rps9/EC463_Team_03_HUD_Glasses/images/temp_d849b771-32f3-4060-8334-6a91f4f5c3f0.jpg

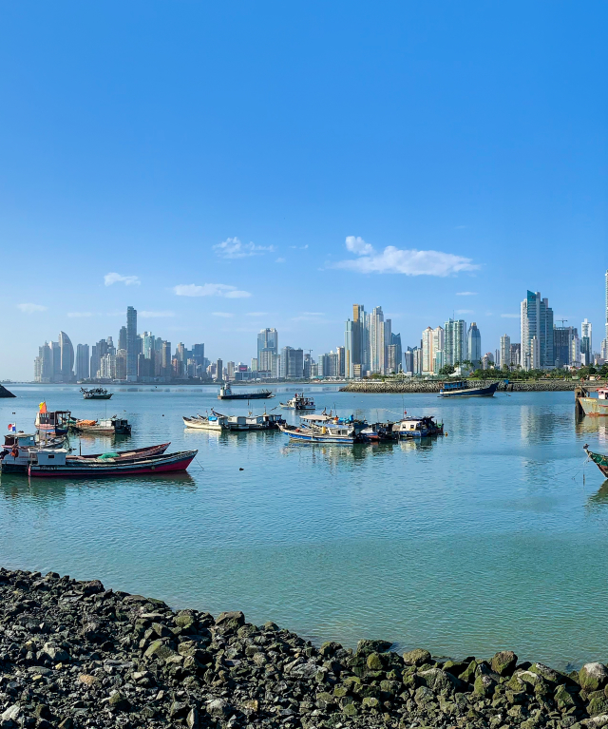
images/temp_d849b771-32f3-4060-8334-6a91f4f5c3f0.jpg
