rps9/EC463_Team_03_HUD_Glasses/README.md

# Team 3: HUDini

<p align="center">

</p>
<p align="center">
This is our team
</p>

## Description
We’re building a live translation device that utilizes a microphone and Head-Up Display (HUD) to turn spoken foreign speech into real-time English captions, all housed in a pair of glasses. A companion app learns user style to suggest relevant replies, which are displayed phonetically for easy pronunciation on the HUD.

## Objectives
The HUDini will enable fluid two-way conversation, accelerate language learning, and generally facilitate communication across various languages. Planned deliverables: working product with live speech translation and response suggestion.

## Team links
- [Team Google Drive](https://drive.google.com/drive/folders/1bL06aGVt6rRM7B_IEEJm4XVPyzq0NuTs)

## Course links
- [ECE Senior Design Piazza Site](https://piazza.com/bu/fall2025/ec463/home)
- [Blackboard](http://learn.bu.edu/)

## Optional features links
- [Team Jira](https://hudinihudini.atlassian.net/jira/software/projects/SCRUM/boards/1/backlog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)
