rps9/EC463_Team_03_HUD_Glasses/hardware/pcb/HUDini_charger/HUDini.csv

Reference | Qty | Value | DNP | Exclude from BOM | Exclude from Board | Footprint | Datasheet
BT1,BT2 | 2 | LIR2450 |  |  |  | Connector_Wire:SolderWire-0.15sqmm_1x02_P4mm_D0.5mm_OD1.5mm | ~
C1,C2,C6,C8,C9,C12,C16 | 7 | 0.1uF |  |  |  | Capacitor_SMD:C_0603_1608Metric_Pad1.08x0.95mm_HandSolder | ~
C3,C4,C5,C15 | 4 | 4.7uF |  |  |  | Capacitor_SMD:C_0603_1608Metric_Pad1.08x0.95mm_HandSolder | ~
C7,C11,C13,C14 | 4 | 10uF |  |  |  | Capacitor_SMD:C_0603_1608Metric_Pad1.08x0.95mm_HandSolder | ~
C10 | 1 | 1uF |  |  |  | Capacitor_SMD:C_0603_1608Metric_Pad1.08x0.95mm_HandSolder | ~
D1,D4 | 2 | LED |  |  |  | LED_SMD:LED_0603_1608Metric_Pad1.05x0.95mm_HandSolder | ~
D2 | 1 | SP0503BAHT |  |  |  | Package_TO_SOT_SMD:SOT-143 | http://www.littelfuse.com/~/media/files/littelfuse/technical%20resources/documents/data%20sheets/sp05xxba.pdf
J1 | 1 | USB_B_Micro |  |  |  | Connector_USB:USB_Micro-B_Amphenol_10103594-0001LF_Horizontal | ~
J3 | 1 | Conn_01x06_Pin |  |  |  | Connector_Wire:SolderWire-0.15sqmm_1x06_P4mm_D0.5mm_OD1.5mm | ~
J4 | 1 | Conn_01x07_Pin |  |  |  | Connector_PinHeader_2.00mm:PinHeader_1x07_P2.00mm_Horizontal | ~
L1 | 1 | LPS3015-153MRC |  |  |  | footprints:LPS3015 | LPS3015-153MRC
Q1,Q2 | 2 | Q_NMOS_SSSGD_AvalancheRated |  |  |  | Package_SON:VSON-8_3.3x3.3mm_P0.65mm_NexFET | ~
R1 | 1 | 5.1M |  | Excluded from BOM |  | Resistor_SMD:R_0603_1608Metric_Pad0.98x0.95mm_HandSolder | ~
R2 | 1 | 5.1M |  |  |  | Resistor_SMD:R_0603_1608Metric_Pad0.98x0.95mm_HandSolder | ~
R3 | 1 | 2.2K |  |  |  | Resistor_SMD:R_0603_1608Metric_Pad0.98x0.95mm_HandSolder | ~
R4,R19 | 2 | 330 |  |  |  | Resistor_SMD:R_0603_1608Metric_Pad0.98x0.95mm_HandSolder | ~
R5 | 1 | 22K |  |  |  | Resistor_SMD:R_0603_1608Metric_Pad0.98x0.95mm_HandSolder | ~
R6 | 1 | 470 |  |  |  | Resistor_SMD:R_0603_1608Metric_Pad0.98x0.95mm_HandSolder | ~
R7 | 1 | 1K |  |  |  | Resistor_SMD:R_0603_1608Metric_Pad0.98x0.95mm_HandSolder | ~
R8 | 1 | 22.1K |  |  |  | Resistor_SMD:R_0603_1608Metric_Pad0.98x0.95mm_HandSolder | ~
R9 | 1 | 47.5K |  |  |  | Resistor_SMD:R_0603_1608Metric_Pad0.98x0.95mm_HandSolder | ~
R10,R16,R17,R18 | 4 | 10K |  |  |  | Resistor_SMD:R_0603_1608Metric_Pad0.98x0.95mm_HandSolder | ~
R11,R12,R13,R14,R15 | 5 | 27 |  |  |  | Resistor_SMD:R_0603_1608Metric_Pad0.98x0.95mm_HandSolder | ~
SW1 | 1 | RESET |  |  |  | Button_Switch_SMD:SW_SPST_PTS810 | ~
SW2 | 1 | BOOT |  |  |  | Button_Switch_SMD:SW_SPST_PTS810 | ~
SW3 | 1 | PWR_REC |  |  |  | Button_Switch_SMD:SW_SPST_PTS645Sx43SMTR92 | ~
SW5 | 1 | SW_SPDT |  |  |  | Button_Switch_THT:SW_E-Switch_EG1224_SPDT_Angled | ~
U1 | 1 | TPS63031DSK |  |  |  | Package_SON:WSON-10-1EP_2.5x2.5mm_P0.5mm_EP1.2x2mm | http://www.ti.com/lit/ds/symlink/tps63031.pdf
U2 | 1 | CP2102N-Axx-xQFN24 |  |  |  | Package_DFN_QFN:QFN-24-1EP_4x4mm_P0.5mm_EP2.6x2.6mm | https://www.silabs.com/documents/public/data-sheets/cp2102n-datasheet.pdf
U3 | 1 | BQ29700DSER |  |  |  | Package_SON:WSON-6_1.5x1.5mm_P0.5mm
U4 | 1 | MCP73831-2-OT |  |  |  | Package_TO_SOT_SMD:SOT-23-5 | http://ww1.microchip.com/downloads/en/DeviceDoc/20001984g.pdf
U5 | 1 | ESP32-WROOM-32E |  |  |  | RF_Module:ESP32-WROOM-32E | https://www.espressif.com/sites/default/files/documentation/esp32-wroom-32e_esp32-wroom-32ue_datasheet_en.pdf
