rps9/EC463_Team_03_HUD_Glasses/docs/standards_used.csv

No. | Standards Body | Standard No | Description | Comment | URL
1 | Bluetooth SIG | Bluetooth Core Specification v6.2 | Bluetooth Low Energy, including GAP, GATT, ATT, characteristics, writes, and notifications | Used for iPhone-to-Frame communication and ESP32/nRF BLE prototype firmware. | https://www.bluetooth.com/wp-content/uploads/Files/Specification/HTML/Core-62/out/en/index-en.html
2 | Apple | App Store Review Guidelines 5.1.1 | Privacy, data collection, user consent, and required disclosures for iOS apps | Applies because HUDini uses microphone, speech recognition, Bluetooth, location permission, account login, and AI/network services. | https://developer.apple.com/app-store/review/guidelines/#data-collection-and-storage
3 | OWASP | OWASP MASVS v2 | Mobile Application Security Verification Standard | Applies to iOS token storage, permissions, network calls, platform API use, and local conversation history. | https://mas.owasp.org/MASVS/
4 | IETF | RFC 8446 | Transport Layer Security (TLS) Protocol Version 1.3 | Used conceptually for HTTPS protection between the iOS app, backend API, Google, and OpenAI services. | https://datatracker.ietf.org/doc/html/rfc8446
5 | IETF | RFC 9110 | HTTP Semantics | Used by FastAPI backend endpoints and iOS URLSession clients for REST-style API requests and responses. | https://datatracker.ietf.org/doc/html/rfc9110
6 | IETF | RFC 8259 | JavaScript Object Notation (JSON) Data Interchange Format | Used for backend request/response bodies, local conversation history encoding, and OpenAI API payloads. | https://datatracker.ietf.org/doc/html/rfc8259
7 | IETF | RFC 7519 | JSON Web Token (JWT) | Used for backend access tokens and iOS authentication-session validation. | https://datatracker.ietf.org/doc/html/rfc7519
8 | NIST | NIST SP 800-63B | Digital Identity Guidelines: Authentication and Lifecycle Management | Applies to password length/handling, account authentication, session lifetime, and identity assurance decisions. | https://pages.nist.gov/800-63-4/sp800-63b.html
9 | OpenID Foundation | OpenID Connect Core 1.0 | Federated identity layer on OAuth 2.0 | Used for Google Sign-In ID token authentication and backend verification. | https://openid.net/specs/openid-connect-core-1_0.html
10 | IETF | BCP 47 / RFC 5646 | Tags for Identifying Languages | Used for language codes passed to Apple Speech, Apple Translation, and HUDini language selection. | https://datatracker.ietf.org/doc/html/rfc5646
11 | USB-IF / IEC | USB Type-C Cable and Connector Specification / IEC 62680-1-3 | USB-C connector and power-only charging input requirements | Applies to the charger PCB USB-C receptacle and CC resistor design. | https://www.usb.org/document-library/usb-type-cr-cable-and-connector-specification-release-24
12 | FCC | 47 CFR Part 15 | Radio Frequency Devices | Applies to BLE radio emissions and unintentional emissions from the wearable electronics. | https://www.ecfr.gov/current/title-47/chapter-I/subchapter-A/part-15
13 | IEC | IEC 62368-1:2023 | Audio/video, information and communication technology equipment safety | Applies to the battery-powered wearable electronics, display, charging circuitry, and connected ICT hardware. | https://webstore.iec.ch/en/publication/69308
14 | IEC | IEC 62133-2:2017 | Safety requirements for portable sealed secondary lithium cells and batteries | Applies to the rechargeable battery/charger portion of the custom hardware design. | https://webstore.iec.ch/en/publication/32662
15 | IPC | IPC-2221 | Generic Standard on Printed Board Design | Applies to PCB layout, conductor spacing, design rules, and manufacturability of the HUDini charger board. | https://shop.electronics.org/ipc-2221/ipc-2221-standard-only/Revision-c/english
