rps9/EC463_Team_03_HUD_Glasses/docs/block_diagram.pdf

# APP

# GLASSES

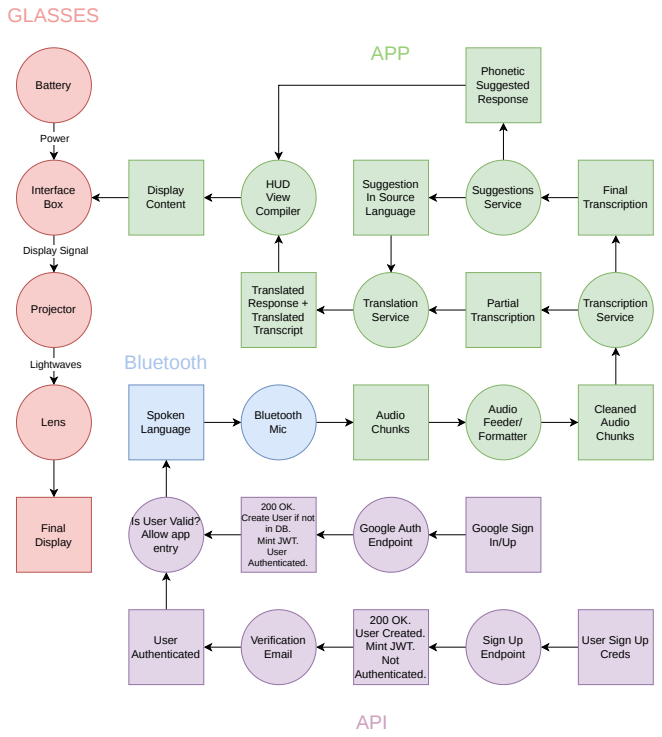
[picture p4: page 1]
Bluetooth Mic; Transcription Service; Spoken Language; Audio Chunks; Cleaned Audio Chunks; Audio Feeder/ Formatter; Partial Transcription; Translation Service; Suggestions Service; Final Transcription; Suggestion In Source Language; HUD View Compiler; Translated Response + Translated Transcript; Phonetic Suggested Response; Display Content; Power; Battery; Display Signal; Interface Box; Lightwaves; Projector; Lens; Final Display; Sign Up Endpoint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

Create User if not
Mint JWT.
User
Authenticated.

Is User Valid?
Allow app
entry

User Sign Up
Creds
