rps9/EC463_Team_03_HUD_Glasses/hardware/pcb/HUDini_charger/HUDini.kicad_pcb

## KiCad design hardware/pcb/HUDini_charger/HUDini.kicad_pcb (2026-04-20)

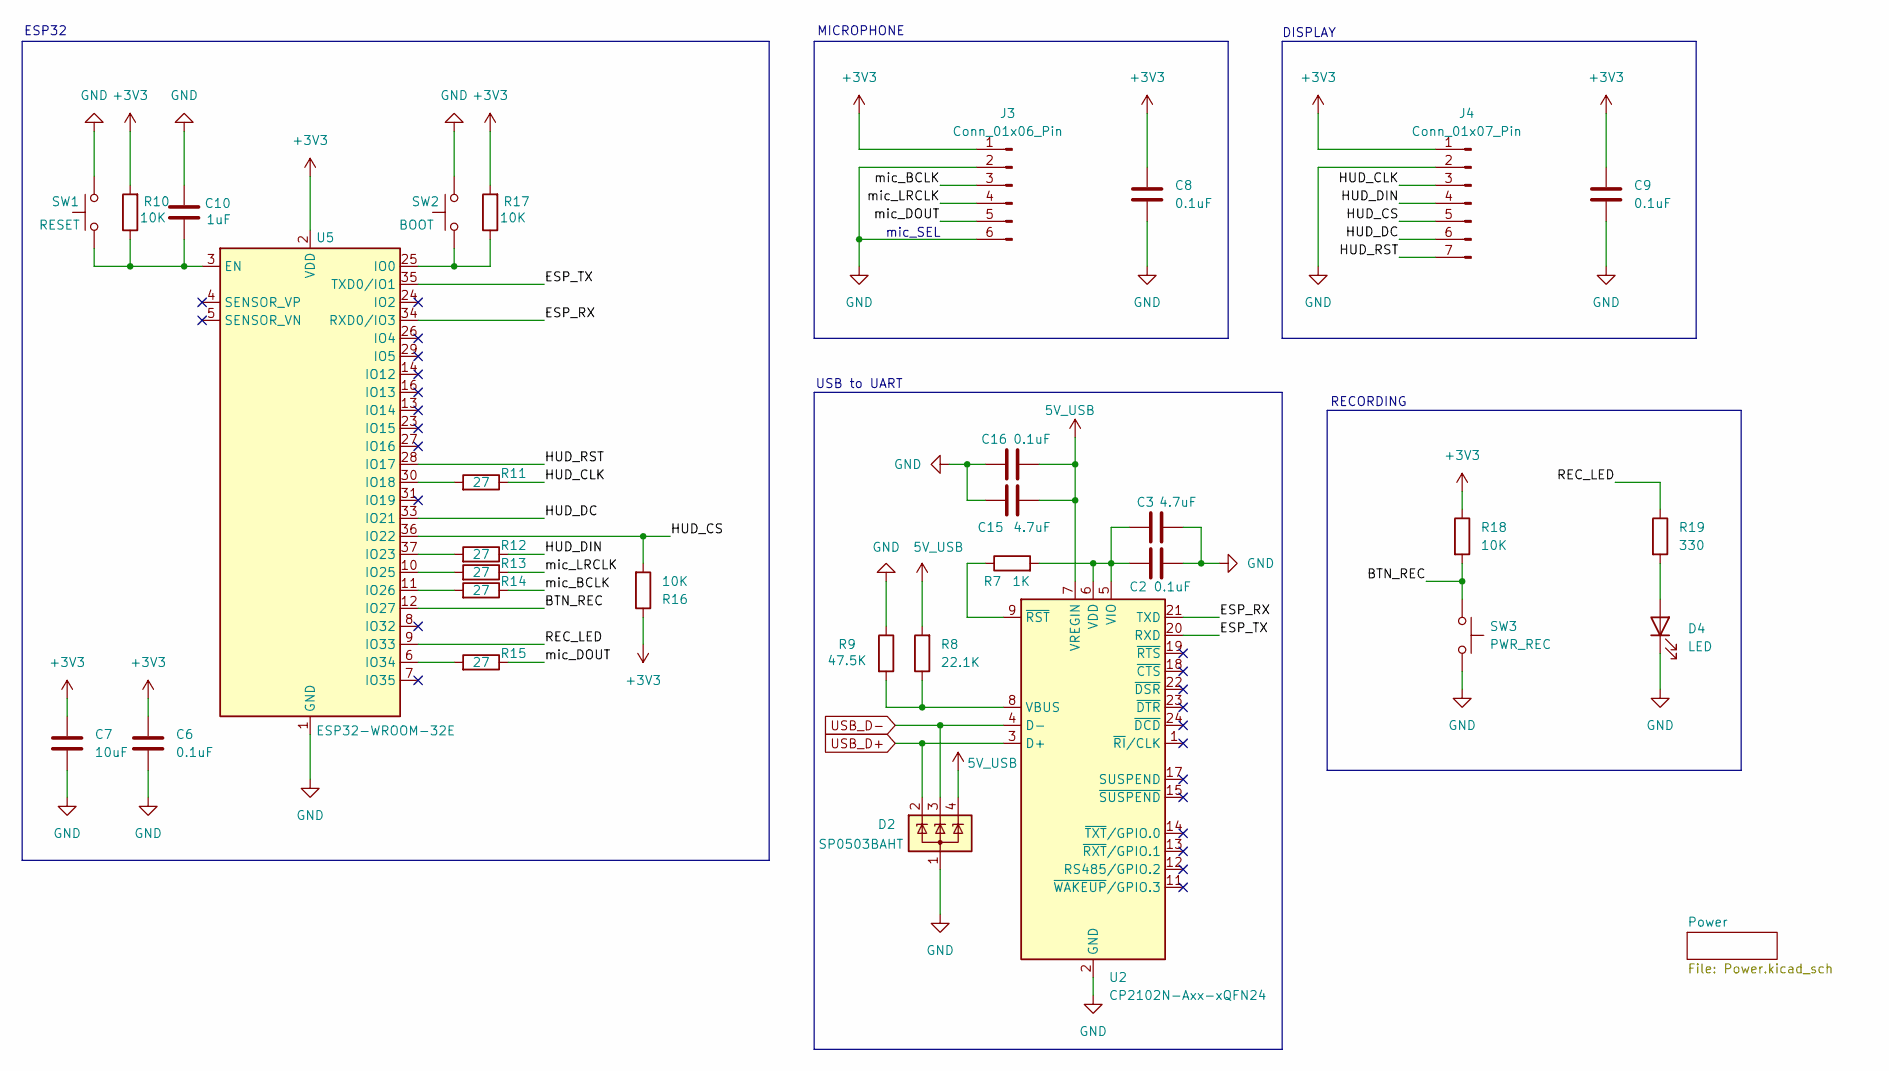
[picture p5: schematic HUDini.kicad_sch]

Parts:
C2, C6, C8, C9, C16: 0.1uF; C_0603_1608Metric_Pad1.08x0.95mm_HandSolder
C3, C15: 4.7uF; C_0603_1608Metric_Pad1.08x0.95mm_HandSolder
C7: 10uF; C_0603_1608Metric_Pad1.08x0.95mm_HandSolder
C10: 1uF; C_0603_1608Metric_Pad1.08x0.95mm_HandSolder
D2: SP0503BAHT; SOT-143
D4: LED; LED_0603_1608Metric_Pad1.05x0.95mm_HandSolder
J3: Conn_01x06_Pin; SolderWire-0.15sqmm_1x06_P4mm_D0.5mm_OD1.5mm
J4: Conn_01x07_Pin; PinHeader_1x07_P2.00mm_Horizontal
R7: 1K; R_0603_1608Metric_Pad0.98x0.95mm_HandSolder
R8: 22.1K; R_0603_1608Metric_Pad0.98x0.95mm_HandSolder
R9: 47.5K; R_0603_1608Metric_Pad0.98x0.95mm_HandSolder
R10, R16, R17, R18: 10K; R_0603_1608Metric_Pad0.98x0.95mm_HandSolder
R11, R12, R13, R14, R15: 27; R_0603_1608Metric_Pad0.98x0.95mm_HandSolder
R19: 330; R_0603_1608Metric_Pad0.98x0.95mm_HandSolder
SW1: RESET; SW_SPST_PTS810
SW2: BOOT; SW_SPST_PTS810
SW3: PWR_REC; SW_SPST_PTS645Sx43SMTR92
U2: CP2102N-Axx-xQFN24; QFN-24-1EP_4x4mm_P0.5mm_EP2.6x2.6mm
U5: ESP32-WROOM-32E

Connections:
5V_USB: C15.1, C16.1, D2.4 (K), R8.2, U2.7 (VREGIN); also elsewhere on the board
+3V3: C6.1, C7.1, C8.1, C9.1, J3.1, J4.1, R10.2, R16.1, R17.2, R18.1, U5.2 (VDD); also elsewhere on the board
/BTN_REC: R18.2, SW3.1, U5.12 (IO27)
/ESP_RX: U2.21 (TXD), U5.34 (RXD0/IO3)
/ESP_TX: U2.20 (RXD), U5.35 (TXD0/IO1)
/HUD_CLK: J4.3, R11.1
/HUD_CS: J4.5, R16.2, U5.36 (IO22)
/HUD_DC: J4.6, U5.33 (IO21)
/HUD_DIN: J4.4, R12.1
/HUD_RST: J4.7, U5.28 (IO17)
/REC_LED: R19.1, U5.9 (IO33)
/mic_BCLK: J3.3, R14.1
/mic_DOUT: J3.5, R15.1
/mic_LRCLK: J3.4, R13.1
GND: C2.2, C3.2, C6.2, C7.2, C8.2, C9.2, C10.2, C15.2, C16.2, D2.1 (A), D4.1 (K), J3.2, J3.6, J4.2, R9.1, SW1.2, SW2.2, SW3.2, U2.2 (GND), U2.25 (GND), U5.1 (GND), U5.15 (GND), U5.38 (GND), U5.39 (GND); also elsewhere on the board
unnamed: D4.2 (A), R19.2
unnamed: R8.1, R9.2, U2.8 (VBUS)
unnamed: C2.1, C3.1, R7.2, U2.5 (VIO), U2.6 (VDD)
unnamed: R7.1, U2.9 (~RST)
unnamed: C10.1, R10.1, SW1.1, U5.3 (EN)
unnamed: R17.1, SW2.1, U5.25 (IO0)
unnamed: R11.2, U5.30 (IO18)
unnamed: R12.2, U5.37 (IO23)
unnamed: R13.2, U5.10 (IO25)
unnamed: R14.2, U5.11 (IO26)
unnamed: R15.2, U5.6 (IO34)
USB_D+: D2.2 (K), U2.3 (D+); also elsewhere on the board
USB_D-: D2.3 (K), U2.4 (D-); also elsewhere on the board

Notes on the sheet:
RECORDING
USB to UART
MICROPHONE
ESP32
DISPLAY
mic_SEL

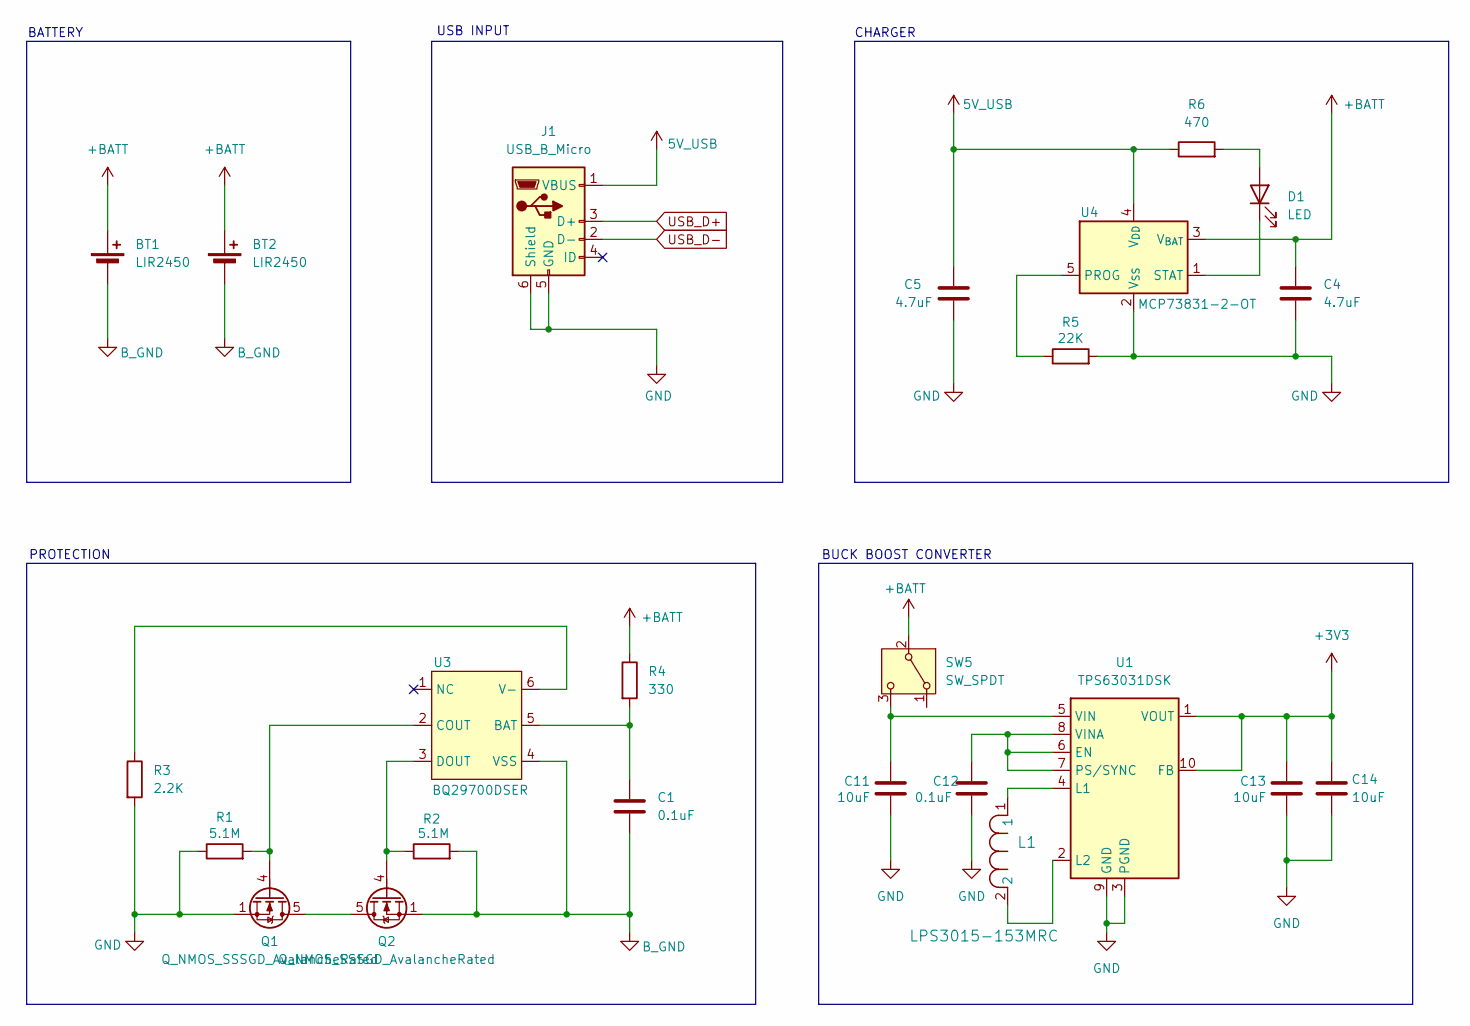
[picture p6: schematic Power.kicad_sch]

Parts:
BT1, BT2: LIR2450; SolderWire-0.15sqmm_1x02_P4mm_D0.5mm_OD1.5mm
C1, C12: 0.1uF; C_0603_1608Metric_Pad1.08x0.95mm_HandSolder
C4, C5: 4.7uF; C_0603_1608Metric_Pad1.08x0.95mm_HandSolder
C11, C13, C14: 10uF; C_0603_1608Metric_Pad1.08x0.95mm_HandSolder
D1: LED; LED_0603_1608Metric_Pad1.05x0.95mm_HandSolder
J1: USB_B_Micro; USB_Micro-B_Amphenol_10103594-0001LF_Horizontal
L1: LPS3015-153MRC; LPS3015
Q1, Q2: Q_NMOS_SSSGD_AvalancheRated; VSON-8_3.3x3.3mm_P0.65mm_NexFET
R1, R2: 5.1M; R_0603_1608Metric_Pad0.98x0.95mm_HandSolder
R3: 2.2K; R_0603_1608Metric_Pad0.98x0.95mm_HandSolder
R4: 330; R_0603_1608Metric_Pad0.98x0.95mm_HandSolder
R5: 22K; R_0603_1608Metric_Pad0.98x0.95mm_HandSolder
R6: 470; R_0603_1608Metric_Pad0.98x0.95mm_HandSolder
SW5: SW_SPDT; SW_E-Switch_EG1224_SPDT_Angled
U1: TPS63031DSK; WSON-10-1EP_2.5x2.5mm_P0.5mm_EP1.2x2mm
U3: BQ29700DSER; WSON-6_1.5x1.5mm_P0.5mm
U4: MCP73831-2-OT; SOT-23-5

Connections:
5V_USB: C5.1, J1.1 (VBUS), R6.1, U4.4 (V_{DD}); also elsewhere on the board
+3V3: C13.1, C14.1, U1.1 (VOUT), U1.10 (FB); also elsewhere on the board
+BATT: BT1.1 (+), BT2.1 (+), C4.1, R4.1, SW5.2 (B), U4.3 (V_{BAT})
B_GND: BT1.2 (-), BT2.2 (-), C1.2, Q2.1 (S), Q2.2 (S), Q2.3 (S), R2.2, U3.4 (VSS)
GND: C4.2, C5.2, C11.2, C12.1, C13.2, C14.2, J1.5 (GND), J1.6 (Shield), Q1.1 (S), Q1.2 (S), Q1.3 (S), R1.1, R3.2, R5.2, U1.3 (PGND), U1.9 (GND), U1.11 (PGND), U4.2 (V_{SS}); also elsewhere on the board
unnamed: D1.2 (A), R6.2
unnamed: D1.1 (K), U4.1 (STAT)
unnamed: Q1.5 (D), Q2.5 (D)
unnamed: Q1.4 (G), R1.2, U3.2 (COUT)
unnamed: Q2.4 (G), R2.1, U3.3 (DOUT)
unnamed: C11.1, SW5.3 (C), U1.5 (VIN)
unnamed: C12.2, U1.6 (EN), U1.7 (PS/SYNC), U1.8 (VINA)
unnamed: L1.1, U1.4 (L1)
unnamed: L1.2, U1.2 (L2)
unnamed: C1.1, R4.2, U3.5 (BAT)
unnamed: R3.1, U3.6 (V-)
unnamed: R5.1, U4.5 (PROG)
USB_D+: J1.3 (D+); also elsewhere on the board
USB_D-: J1.2 (D-); also elsewhere on the board

Notes on the sheet:
CHARGER
BUCK BOOST CONVERTER
PROTECTION
USB INPUT
BATTERY

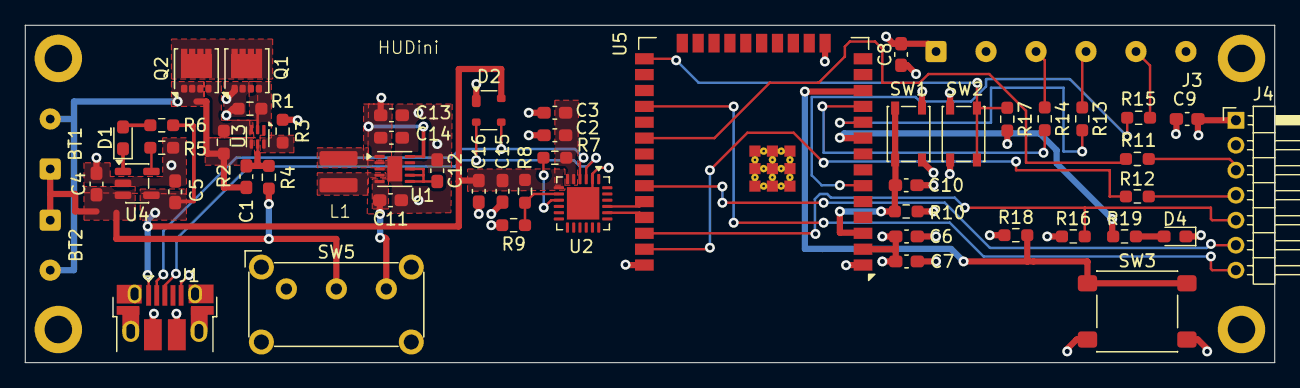
[picture p7: board hardware/pcb/HUDini_charger/HUDini.kicad_pcb from above]

Board: 4 copper layers, 100.0 x 27.0 mm, 55 parts (0 on the bottom side), 42 nets.
