rps9/EC463_Team_03_HUD_Glasses/hardware/pcb/charger/HUDini_charger/HUDini.kicad_pcb

## KiCad design hardware/pcb/charger/HUDini_charger/HUDini.kicad_pcb (2026-03-29)

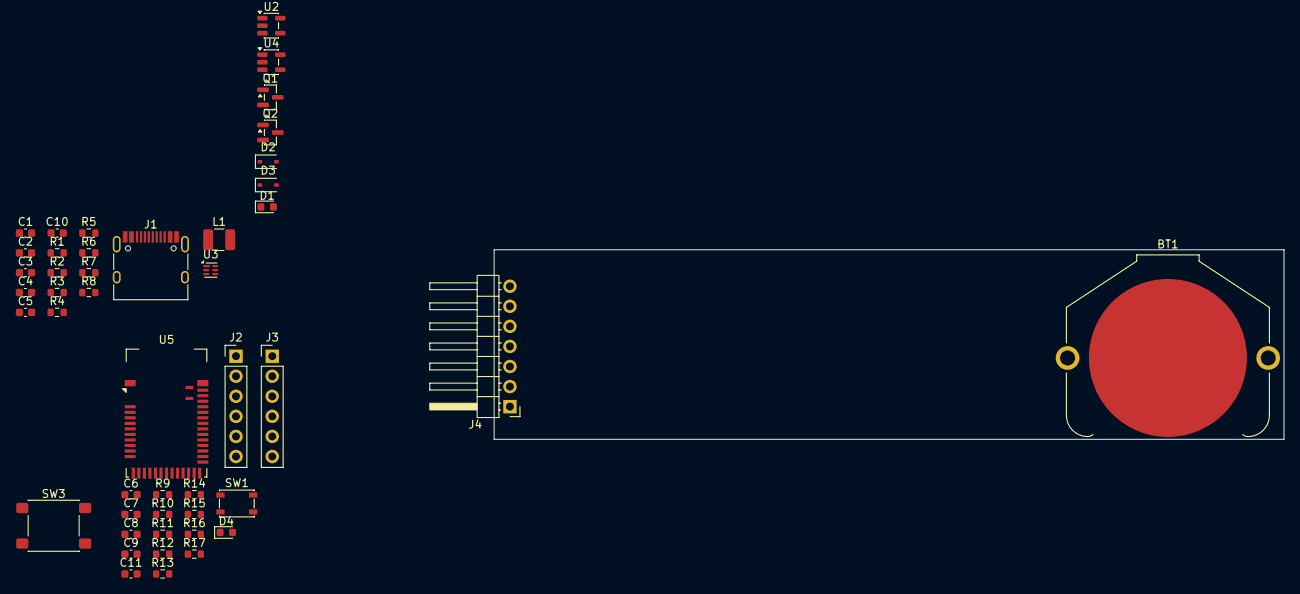
[picture p8: board hardware/pcb/charger/HUDini_charger/HUDini.kicad_pcb from above]

Board: 2 copper layers, 100.0 x 24.0 mm, 46 parts (0 on the bottom side), 38 nets, no tracks yet.

Parts:
BT1: LIR2450; BatteryHolder_Keystone_3009_1x2450
C1: 22uF; C_0603_1608Metric
C2: 10uF; C_0603_1608Metric
C3, C6, C8, C9: 0.1uF; C_0603_1608Metric
C4, C5: 4.7uF; C_0603_1608Metric
C7, C11: 1uF; C_0603_1608Metric
C10: 100uF; C_0603_1608Metric
D1, D4: LED; LED_0603_1608Metric
D2, D3: D_Zener_Filled; D_SOD-323
J1: USB_C_Receptacle_PowerOnly_6P; USB_C_Receptacle_HRO_TYPE-C-31-M-12
J2, J3: Conn_01x06_Pin; PinHeader_1x06_P2.54mm_Vertical
J4: Conn_01x07_Pin; PinHeader_1x07_P2.54mm_Horizontal
L1: 2.2uH; L_1210_3225Metric
Q1: CHG (GDS); SOT-23
Q2: DSG (GDS); SOT-23
R1, R2: 5.1M; R_0603_1608Metric
R3: 2.2K; R_0603_1608Metric
R4, R11: 330; R_0603_1608Metric
R5: 22K; R_0603_1608Metric
R6: 470; R_0603_1608Metric
R7, R8: 5.1K; R_0603_1608Metric
R9: 100K; R_0603_1608Metric
R10, R12: 10K; R_0603_1608Metric
R13, R14, R15, R16, R17: 27; R_0603_1608Metric
SW1: RESET; SW_SPST_PTS810
SW3: PWR_REC; SW_SPST_PTS645Sx43SMTR92
U2: LM3671; SOT-23-5
U3: BQ29700DSER; WSON-6_1.5x1.5mm_P0.5mm
U4: MCP73831-2-OT; SOT-23-5
U5: MDBT42Q-512K; Raytac_MDBT42Q

Connections:
5V_USB: C5.1, D2.2 (A), J1.A9 (VBUS), J1.B9 (VBUS), R6.1, U4.4 (V_{DD})
+3V3: C2.1, C6.1, C7.1, C8.1, C9.1, J2.1, J3.1, J4.1, L1.2, R9.2, R10.1, R12.1, U2.4 (FB), U5.11 (VDD)
/BTN_PWRREC: R10.2, SW3.1, U5.41 (P0.23)
/HUD_CLK: J4.3, R13.1
/HUD_CS: J4.5, R12.2, U5.31 (P0.17)
/HUD_DC: J4.6, U5.33 (P0.19)
/HUD_DIN: J4.4, R14.1
/HUD_RST: J4.7, U5.38 (P0.22)
/REC_LED: R11.1, U5.40 (P0.24)
/RESET: J2.5, R9.1, SW1.1, U5.35 (P0.21/~RESET)
/SWDCLK: J2.3, U5.36 (SWDCLK)
/SWDIO: J2.4, U5.37 (SWDIO)
/UART_TX: J2.6, U5.21 (P0.08)
/mic_BCLK: J3.3, R15.1
/mic_DOUT: J3.5, R17.1
/mic_LRCLK: J3.4, R16.1
B_GND: BT1.2 (-), C3.2, Q2.3 (S), R2.2, U3.4 (VSS)
GND: C1.2, C2.2, C4.2, C5.2, C6.2, C7.2, C8.2, C9.2, C10.2, C11.1, D3.2 (A), D4.1 (K), J1.A12 (GND), J1.B12 (GND), J1.S1 (SHIELD), J2.2, J3.2, J3.6, J4.2, Q1.3 (S), R1.1, R3.2, R5.2, R7.2, R8.2, SW1.2, SW3.2, U2.2 (GND), U4.2 (V_{SS}), U5.1 (GND), U5.12 (GND), U5.24 (GND), U5.39 (GND)
unnamed: D1.2 (A), R6.2
unnamed: D1.1 (K), U4.1 (STAT)
unnamed: D2.1 (K), D3.1 (K)
unnamed: D4.2 (A), R11.2
unnamed: J1.A5 (CC1), R7.1
unnamed: J1.B5 (CC2), R8.1
unnamed: Q1.2 (D), Q2.2 (D)
unnamed: Q1.1 (G), R1.2, U3.2 (COUT)
unnamed: Q2.1 (G), R2.1, U3.3 (DOUT)
unnamed: L1.1, U2.5 (SW)
unnamed: C3.1, R4.2, U3.5 (BAT)
unnamed: R3.1, U3.6 (V-)
unnamed: R5.1, U4.5 (PROG)
unnamed: C11.2, U5.9 (DEC4)
unnamed: R15.2, U5.25 (P0.11)
unnamed: R16.2, U5.26 (P0.12)
unnamed: R17.2, U5.27 (P0.13)
unnamed: R13.2, U5.30 (TRACEDATA1/P0.16)
unnamed: R14.2, U5.29 (TRACEDATA2/P0.15)
VBAT: BT1.1 (+), C1.1, C4.1, C10.1, R4.1, U2.1 (VIN), U2.3 (EN), U4.3 (V_{BAT})
