rps9/EC463_Team_03_HUD_Glasses/(commit log)

2026-03-28 HUD live: wire mic transcription and translation; add Language tab
    - Replace HUDLiveView demo timeline with TranscriptionManager pipeline;
    show translated renderedText on the HUD with character limit.
    - Request speech permissions on appear; surface statusMessage.
    - Debounce OpenAI suggestion refresh in the view (450ms).
    - Add LanguageView for iOS 26 Translation language packs; include related
    tab, translation options, and companion UI updates.
    Made-with: Cursor
2026-03-28 changing sign in flow
2026-03-29 Created Folder for PCB Files
2026-03-29 Created README.md for PCB
2026-03-29 Created charger file
2026-03-29 Added Charger Schematics
2026-03-29 Added Charger Files
2026-03-31 frame ideas
2026-04-02 phonemizer prototype
2026-04-05 frame stuff kind of working
2026-04-07 updates to frame
2026-04-07 improvements to the frame code
2026-04-13 Updated PCB Files
2026-04-17 Some Components Finished Wiring
    Buck-Boost Converter, USB-to-UART, Protection, Charger. Next step is every connection to ESP32
2026-04-20 Updated PCB
2026-04-20 BOM and added datasheet
2026-04-23 ui changes and supporting ESP32
